Smileydude23/Half-Life---Week-5-Hydroplanter/README.md

# Half-Life---Week-5-Hydroplanter
A plant waterer that uses moisture sensors to detect when the plant needs watering, then a pump will pump water from a bowl/bottle of water to the plant. The design was made in KiCad and the code was made in Arduino IDE. I made this project because my plant, Dusty, is in need of consistent watering and it suffers a lot from when I leave the house for extended periods of time, like when I am camping. The PCB is built around an ESP32-C3 microcontroller. It monitors soil moisture and water level, controls a pump through a MOSFET, manages battery charging and protection, and displays status information on an OLED. The wiring is really trash because I'm bad at wiring but it should work. The Arduino firmware I wrote monitors soil moisture and water-tank availability, displays the plant’s moisture level on an OLED screen, and automatically controls a pump. It starts watering when the soil moisture falls to 30% or below, stops at 55%, and includes safety limits for an empty tank, a 15-second maximum runtime, and a 10-minute delay between watering cycles. It also averages multiple soil-sensor readings, converts them into a 0–100% moisture value, and shows the plant graphic, status, and sensor data on the display.

Onshape Link:
https://cad.onshape.com/documents/5bbc0352c67ef33b2cdba1d2/w/0c9466e1c6beb604306bf71a/e/59fa4b2cb4097b58a1eba9d7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

## Bill of Materials

| Part | Qty | Unit Price (USD) | Total (USD) | Vendor |
| :--- | :---: | :---: | :---: | :--- |
| **1/4" Vinyl Tubing** <br> | 1 | $3.83 | $3.83 | Temu |
| **0.96-inch OLED Display Module I2C** <br> | 1 | $1.98 | $1.98 | Temu |
| **2pcs/lot 18650 Battery Case** <br> | 1 | $1.44 | $1.44 | Temu |
| **MF-RHT050-0** <br> | 2 | $1.87 | $3.74 | Digikey |
| **SS14** <br> | 3 | $1.38 | $4.14 | Digikey |
| **USB4125-GF-A** <br> | 1 | $0.64 | $0.64 | Digikey |
| **IRLZ44NPBF** <br> | 1 | $2.02 | $2.02 | Digikey |
| **FS8205A** <br> | 1 | $0.69 | $0.69 | Digikey |
| **MFR-25FTF52-1K5** <br> | 2 | $0.21 | $0.42 | Digikey |
| **MFR-25FBF52-732K** <br> | 1 | $0.11 | $0.11 | Digikey |
| **DW01A** <br> | 1 | $0.11 | $0.11 | Digikey |
| **BQ24074RGTR** <br> | 1 | $2.73 | $2.73 | Digikey |
| **SMD IC MT3608** <br> | 1 | $0.29 | $0.29 | Digikey |
| **K104K15X7RF53L2** <br> | 2 | $0.57 | $1.14 | Digikey |
| **FK22X7R1E475K0000** <br> | 1 | $1.63 | $1.63 | Digikey |
| **S3B-PH-K-S** <br> | 1 | $0.16 | $0.16 | Digikey |
| **S2B-PH-K-S** <br> | 2 | $0.26 | $0.52 | Digikey |
| **78F4R7J-RC** <br> | 1 | $0.25 | $0.25 | Digikey |
| **I13991054** <br> | 1 | $1.21 | $1.21 | Aliexpress |
| **SEN0193** <br> | 1 | $6.21 | $6.21 | Digikey |
| **4547** <br> | 1 | $3.31 | $3.31 | Digikey |
| **PLS-03IA-3PAI** <br> | 1 | $3.19 | $3.19 | Digikey |
| **50YXJ22MTA5X11** <br> | 1 | $0.28 | $0.28 | Digikey |
| **PCB Manufacturing** <br> | 1 | $4.00 | $4.00 | JLCPCB |
| **Tax & shipping** <br> | — | — | $17.08 | — |
| **Total Funding Used** | — | — | **$61.12 / $65** | |






DigiKey - Shopping Cart
Aliexpress
Temu
JLCPCB
