Smileydude23/Half-Life---Week-5-Hydroplanter/Hydroplanter.xlsx

Reference | Qty | Value | DNP | Exclude from BOM | Exclude from Board | Exclude from Simulation | Exclude from Position Files | Footprint | Datasheet | Personal Notes for Making Half Life BOM |  |  |  |  |  | Store | Price | Site
BT1,BT2 | 2 | BK-18650-PC2 |  |  |  |  | ${EXCLUDE_FROM_POS_FILES} | hydroplanter:BAT_BK-18650-PC2 | https://s3.amazonaws.com/snapeda/datasheet/BK-18650-PC2_MPD.pdf | BK-18650 Single Battery Shield |  |  | Buy 2 |  |  | Temu | 2.03 | https://www.temu.com/ca/2pcs-lot-18650-power-bank-cases-3-7v-high-quality-diy-battery-box-hard-case-container-with-hard-pin-easy-welding-g-601099632413335.htm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
C1,C2 | 2 | 100nf |  |  |  |  | ${EXCLUDE_FROM_POS_FILES} | Capacitor_THT:C_Disc_D5.0mm_W2.5mm_P5.00mm |  | Disc Capacitor (100nf) |  |  | Buy 2 |  |  | Digikey | 0.8
C3 | 1 | 4.7uf |  |  |  |  | ${EXCLUDE_FROM_POS_FILES} | Capacitor_THT:C_Disc_D5.0mm_W2.5mm_P5.00mm |  | Disc Capacitor (4.7uf) |  |  |  |  |  | Digikey | 2.3
C4,C5 | 2 | 22uf |  |  |  |  | ${EXCLUDE_FROM_POS_FILES} | Capacitor_THT:C_Disc_D5.0mm_W2.5mm_P5.00mm |  | Disc Capacitor (22uf) |  |  |  |  |  | Digikey | 0.4
D1,D2,D3 | 3 | SS14 |  |  |  |  | ${EXCLUDE_FROM_POS_FILES} | Diode_SMD:D_SMA | https://www.vishay.com/docs/88746/ss12.pdf | Schottky Diode SS14 |  |  | Buy 3 |  |  | Digikey | 1.95
F1,F2 | 2 | Polyfuse |  |  |  |  | ${EXCLUDE_FROM_POS_FILES} | Fuse:Fuse_Bourns_MF-RHT050 |  | THT Polyfuse |  |  | Buy 2 |  |  | Digikey | 2.64
J1 | 1 | Conn_01x03 (Soil) |  |  |  |  | ${EXCLUDE_FROM_POS_FILES} | Connector_Phoenix_GMSTB:PhoenixContact_GMSTBA_2,5_3-G-7,62_1x03_P7.62mm_Horizontal |  | 3 pin male connector |  |  | Right angle preffered, vertical is fine |  |  | Digikey | 0.22
J2 | 1 | Conn_01x02 (Water) |  |  |  |  | ${EXCLUDE_FROM_POS_FILES} | Connector_Phoenix_GMSTB:PhoenixContact_GMSTBA_2,5_2-G_1x02_P7.50mm_Horizontal |  | 2 pin male connector |  |  | Right angle preffered, vertical is fine |  |  | Digikey | 0.36
J3 | 1 | Conn_01x02 (Pump) |  |  |  |  | ${EXCLUDE_FROM_POS_FILES} | Connector_Phoenix_GMSTB:PhoenixContact_GMSTBA_2,5_2-G_1x02_P7.50mm_Horizontal |  | 2 pin male connector |  |  | Right angle preffered, vertical is fine
J4 | 1 | USB_C_Receptacle_PowerOnly_6P |  |  |  |  | ${EXCLUDE_FROM_POS_FILES} | Connector_USB:USB_C_Receptacle_GCT_USB4125-xx-x-0190_6P_TopMnt_Horizontal | https://www.usb.org/sites/default/files/documents/usb_type-c.zip | 6 pin horizontal USBC power only connector |  |  | Right angle |  |  | Digikey | 0.91
L1 | 1 | 4.7uh |  |  |  |  | ${EXCLUDE_FROM_POS_FILES} | Inductor_THT:L_Axial_L7.0mm_D3.3mm_P10.16mm_Horizontal_Fastron_MICC |  | 4.7uh inductor THT |  |  |  |  | ? | Digikey | 0.85
Q1 | 1 | IRLZ44N |  |  |  |  | ${EXCLUDE_FROM_POS_FILES} | Package_TO_SOT_THT:TO-220-3_Vertical | http://www.irf.com/product-info/datasheets/data/irlz44n.pdf | IRLZ44N |  |  |  |  |  | Digikey | 2.85
Q3 | 1 | FS8205A_C908265 |  |  |  |  | ${EXCLUDE_FROM_POS_FILES} | hydroplanter:SOT-23-6_L2.9-W1.6-P0.95-LS2.8-BR | https://lcsc.com/product-detail/MOSFET_FUXINSEMI-FS8205A_C908265.html | FS8205A |  |  |  |  |  | Digikey | 0.95
R1 | 1 | 330 |  |  |  |  | ${EXCLUDE_FROM_POS_FILES} | Resistor_THT:R_Axial_DIN0207_L6.3mm_D2.5mm_P7.62mm_Horizontal |  | THT Resistor 330ohms |  |  |  | Probably just buy a variety resistor kit at this point
R2,R9 | 2 | 10k |  |  |  |  | ${EXCLUDE_FROM_POS_FILES} | Resistor_THT:R_Axial_DIN0207_L6.3mm_D2.5mm_P7.62mm_Horizontal |  | THT Resistor 10k ohms |  |  | Buy 2
R3,R4 | 2 | 5.1k |  |  |  |  | ${EXCLUDE_FROM_POS_FILES} | Resistor_THT:R_Axial_DIN0207_L6.3mm_D2.5mm_P7.62mm_Horizontal |  | THT Resistor 5.1k ohms |  |  | Buy 2
R5,R6 | 2 | 100 |  |  |  |  | ${EXCLUDE_FROM_POS_FILES} | Resistor_THT:R_Axial_DIN0207_L6.3mm_D2.5mm_P7.62mm_Horizontal |  | THT Resistor 100 ohms |  |  | Buy 2
R7 | 1 | 732k |  |  |  |  | ${EXCLUDE_FROM_POS_FILES} | Resistor_THT:R_Axial_DIN0207_L6.3mm_D2.5mm_P7.62mm_Horizontal |  | THT Resistor 732k ohms |  | x |  |  |  | Digikey | 0.15
R8 | 1 | 100k |  |  |  |  | ${EXCLUDE_FROM_POS_FILES} | Resistor_THT:R_Axial_DIN0207_L6.3mm_D2.5mm_P7.62mm_Horizontal |  | THT Resistor 100k ohms
R10,R11 | 2 | 4.7k |  |  |  |  | ${EXCLUDE_FROM_POS_FILES} | Resistor_THT:R_Axial_DIN0207_L6.3mm_D2.5mm_P7.62mm_Horizontal |  | THT Resistor 4.7k ohms |  |  | Buy 2
R12,R13 | 2 | 1.5k |  |  |  |  | ${EXCLUDE_FROM_POS_FILES} | Resistor_THT:R_Axial_DIN0207_L6.3mm_D2.5mm_P7.62mm_Horizontal |  | THT Resistor 1.5k ohms |  | x | Buy 2 |  |  | Digikey | 0.3
U1 | 1 | XIAO-ESP32-C3-SMD |  |  |  |  | ${EXCLUDE_FROM_POS_FILES} | Imported Parts:XIAO-ESP32-C3-SMD |  | XIAO-ESP32-C3 |  |  |  |  |  | Digikey | 8.31 |  | or Aliexpress
U2 | 1 | DW01A_C351410 |  |  |  |  | ${EXCLUDE_FROM_POS_FILES} | hydroplanter:SOT-23-6_L2.9-W1.6-P0.95-LS2.8-BL | https://lcsc.com/product-detail/Others_PUOLOP-DW01_C351410.html | DW01A |  |  |  |  |  | Digikey | 0.16
U3 | 1 | BQ24074RGT |  |  |  |  | ${EXCLUDE_FROM_POS_FILES} | Package_DFN_QFN:VQFN-16-1EP_3x3mm_P0.5mm_EP1.6x1.6mm | http://www.ti.com/lit/ds/symlink/bq24074.pdf | BQ24074RGT |  |  |  |  |  | Digikey | 3.85
U4 | 1 | DM-OLED096-636 |  |  |  |  | ${EXCLUDE_FROM_POS_FILES} | hydroplanter3d:MODULE_DM-OLED096-636 | https://snapeda.s3.amazonaws.com/datasheets1361-DM-OLED096-636_Datasheet.pdf | DM-OLED096-636 |  |  |  |  |  | Temu | 2.79 | https://www.temu.com/ca/0-96-inch-oled-display-module--128x64--yellow-white-g-601099658217397.html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
U5 | 1 | MT3608 |  |  |  |  | ${EXCLUDE_FROM_POS_FILES} | Package_TO_SOT_SMD:SOT-23-6 | https://www.olimex.com/Products/Breadboarding/BB-PWR-3608/resources/MT3608.pdf | MT3608 |  |  |  |  |  | Digikey | 0.41
 |  |  |  |  |  |  |  |  |  | Shipping |  |  |  |  |  | Digikey | 15
 |  |  |  |  |  |  |  |  |  | Don't forget to add prices for pcb manufacturing
 |  |  |  |  |  |  |  |  |  | as well as taxes, shipping, and conversion to USD
 |  |  |  |  |  |  |  |  |  | Additional Pieces
 |  |  |  |  |  |  |  |  |  | 1/4 inch vinyl tubing (at least 3 ft long) |  |  |  |  |  | Temu | 5.41
 |  |  |  |  |  |  |  |  |  | waterproof wires
 |  |  |  |  |  |  |  |  |  | connectors/wires for the pump, soil, and water sensors. (when I searched it up online, only the soil moisture sensor came with an attachment, (prefferable waterproof)
 |  |  |  |  |  |  |  |  |  | (when I searched it up online, only the soil moisture sensor came with an attachment, (prefferable waterproof)
 |  |  |  |  |  |  |  |  |  |  | (They should have holes, not have pins)
 |  |  |  |  |  |  |  |  |  |  | DC 3-6V pump |  |  |  |  | Digikey | 4.67
 |  |  |  |  |  |  |  |  |  |  | Soil moisture sensor |  |  |  |  | Digikey | 8.76
 |  |  |  |  |  |  |  |  |  |  | float switch (can be normally open or closed doesn't matter) |  |  |  |  | Digikey | 4.5
