Smileydude23/Half-Life---Week-5-Hydroplanter/BOM.csv

Item | Qty | Supplier | Cost/item | Total Cost | link
Small Engine Fuel Line Hose Available in Four Sizes, Each Measuring 5 Feet And 3 Feet, with Inner And Outer Diameters of | 1 | Temu | $3.83 | $3.83 | https://www.temu.com/goods.html?goods_id=601099522497727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
0.96-inch OLED Display Module I2C IIC 128x64 Blue/Blue Yellow/White | 1 | Temu | $1.98 | $1.98 | https://www.temu.com/goods.html?goods_id=601099658217397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
2pcs/lot 18650 Power Bank Cases 3.7V High Quality DIY Battery Box Hard Case Container with Hard Pin Easy Welding | 1 | Temu | $1.44 | $1.44 | https://www.temu.com/goods.html?goods_id=601099632413335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
MF-RHT050-0 | 2 | Digikey | $1.87 | $3.74 | https://www.digikey.ca/en/products/detail/bourns-inc/MF-RHT050-0/6229412
SS14 | 3 | Digikey | $1.38 | $4.14 | https://www.digikey.ca/en/products/detail/onsemi/SS14/965474
USB4125-GF-A | 1 | Digikey | $0.64 | $0.64 | https://www.digikey.ca/en/products/detail/gct/USB4125-GF-A/13547388
IRLZ44NPBF | 1 | Digikey | $2.02 | $2.02 | https://www.digikey.ca/en/products/detail/infineon-technologies/IRLZ44NPBF/811808
FS8205A | 1 | Digikey | $0.69 | $0.69 | https://www.digikey.ca/en/products/detail/evvo/FS8205A/26220994
MFR-25FTF52-1K5 | 2 | Digikey | $0.21 | $0.42 | https://www.digikey.ca/en/products/detail/yageo/MFR-25FTF52-1K5/9140622
MFR-25FBF52-732K | 1 | Digikey | $0.11 | $0.11 | https://www.digikey.ca/en/products/detail/yageo/MFR-25FBF52-732K/13688
DW01A | 1 | Digikey | $0.11 | $0.11 | https://www.digikey.ca/en/products/detail/shenzhen-slkormicro-semicon-co-ltd/DW01A/28143000
BQ24074RGTR | 1 | Digikey | $2.73 | $2.73 | https://www.digikey.ca/en/products/detail/texas-instruments/BQ24074RGTR/2047269
SMD IC MT3608 | 1 | Digikey | $0.29 | $0.29 | https://www.digikey.ca/en/products/detail/olimex-ltd/SMD-IC-MT3608/29208971
K104K15X7RF53L2 | 2 | Digikey | $0.57 | $1.14 | https://www.digikey.ca/en/products/detail/vishay-beyschlag-draloric-bc-components/K104K15X7RF53L2/2820506
FK22X7R1E475KN000 | 1 | Digikey | $1.63 | $1.63 | https://www.digikey.ca/en/products/detail/tdk/FK22X7R1E475KN000/1008923
S3B-PH-K-S | 1 | Digikey | $0.16 | $0.16 | https://www.digikey.ca/en/products/detail/jst-sales-america-inc/S3B-PH-K-S/926627
S2B-PH-K-S | 2 | Digikey | $0.26 | $0.52 | https://www.digikey.ca/en/products/detail/jst-sales-america-inc/S2B-PH-K-S/926626
78F4R7J-RC | 1 | Digikey | $0.25 | $0.25 | https://www.digikey.ca/en/products/detail/bourns-inc/78F4R7J-RC/1306001
113991054 | 1 | Aliexpress | $1.21 | $1.21 | https://www.aliexpress.com/item/1005008791937363.html?mp=1
SEN0193 | 1 | Digikey | $6.21 | $6.21 | https://www.digikey.ca/en/products/detail/dfrobot/SEN0193/6588605
4547 | 1 | Digikey | $3.31 | $3.31 | https://www.digikey.ca/en/products/detail/adafruit-industries-llc/4547/11627730
PLS-031A-3PAI | 1 | Digikey | $3.19 | $3.19 | https://www.digikey.ca/en/products/detail/pic-gmbh/PLS-031A-3PAI/9687292
50YXJ22MTA5X11 | 1 | Digikey | $0.28 | $0.28 | https://www.digikey.ca/en/products/detail/rubycon/50YXJ22MTA5X11/3134939
PCB Manufacturing | 1 | JLCPCB | $4.00 | $4.00 | https://trade.jlcpcb.com/checkout/payMethod/?unionSettleId=cabd77b163cd4992b6d58ca73438223e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
Estimated total shipping | 1 |  |  | $17.08
