Smileydude23/Half-Life---Week-5-Hydroplanter/Hydroplanter.step

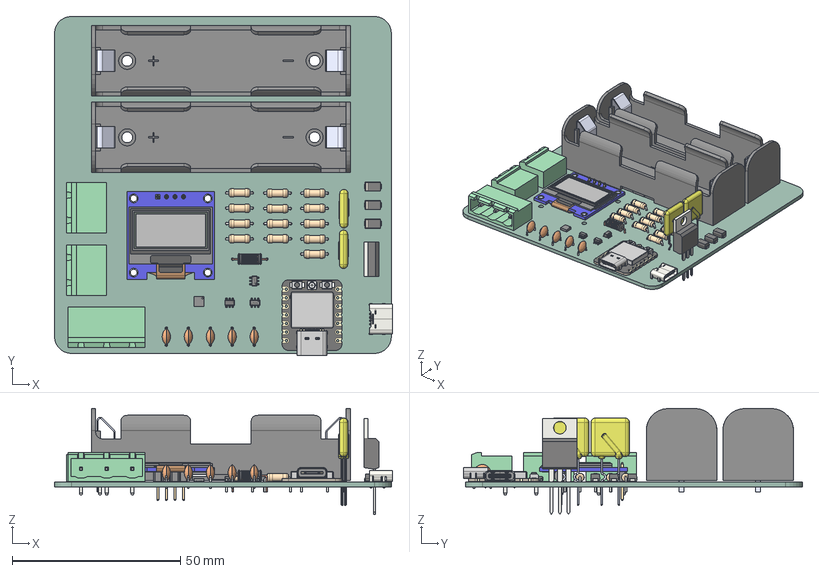
[picture p1: CAD file, 2026-11-08]
Hydroplanter.step
100.3 x 100.6 x 31.5 mm
R_Axial_DIN0207_L63mm_D25mm_P762mm_Horizontal x 13
C_Disc_D50mm_W25mm_P500mm x 5
DM-OLED096-636_Module
DM-OLED096-636_Panel
RGT16
SOT-23-6_L2.9-W1.6-H1.5-LS2.8-P0.95 x 2
GMSTBA_01x03_G_7_62mm
BK-18650-PC2 x 2
D_SMA x 3
GMSTBA_01x02_G_7_50mm x 2
USB_C_Receptacle_GCT_USB4125-xx-x_6P_TopMnt_Horizontal
SOT-23-6
L_Axial_L7.0mm_D3.3mm_P10.16mm_Horizontal_Fastron_MICC
TO-220-3_Vertical
30R250UU x 2
BOSS-EXTRUDE14_8_
BOSS-EXTRUDE7_4_
BOSS-EXTRUDE7_3_
BOSS-EXTRUDE14_4_
BOSS-EXTRUDE14_2_
BOSS-EXTRUDE14_11_
BOSS-EXTRUDE7_7_
BOSS-EXTRUDE14_9_
BOSS-EXTRUDE14_3_
BOSS-EXTRUDE14_7_
MIRROR2
BOSS-EXTRUDE14_5_
BOSS-EXTRUDE14_12_
BOSS-EXTRUDE7_8_
BOSS-EXTRUDE7_1_
BOSS-EXTRUDE14_10_
BOSS-EXTRUDE7_9_
BOSS-EXTRUDE14_6_
BOSS-EXTRUDE14_1_
BOSS-EXTRUDE7_6_
BOSS-EXTRUDE7_2_
CUT-EXTRUDE5
BOSS-EXTRUDE7_5_
U.FL Connector v1
Button (1) x 2
Shield
HydF854_PCB
