Smileydude23/Half-Life---Week-5-Hydroplanter/Hydroplanter.kicad_pcb

## KiCad design Hydroplanter.kicad_pcb (2026-11-08)

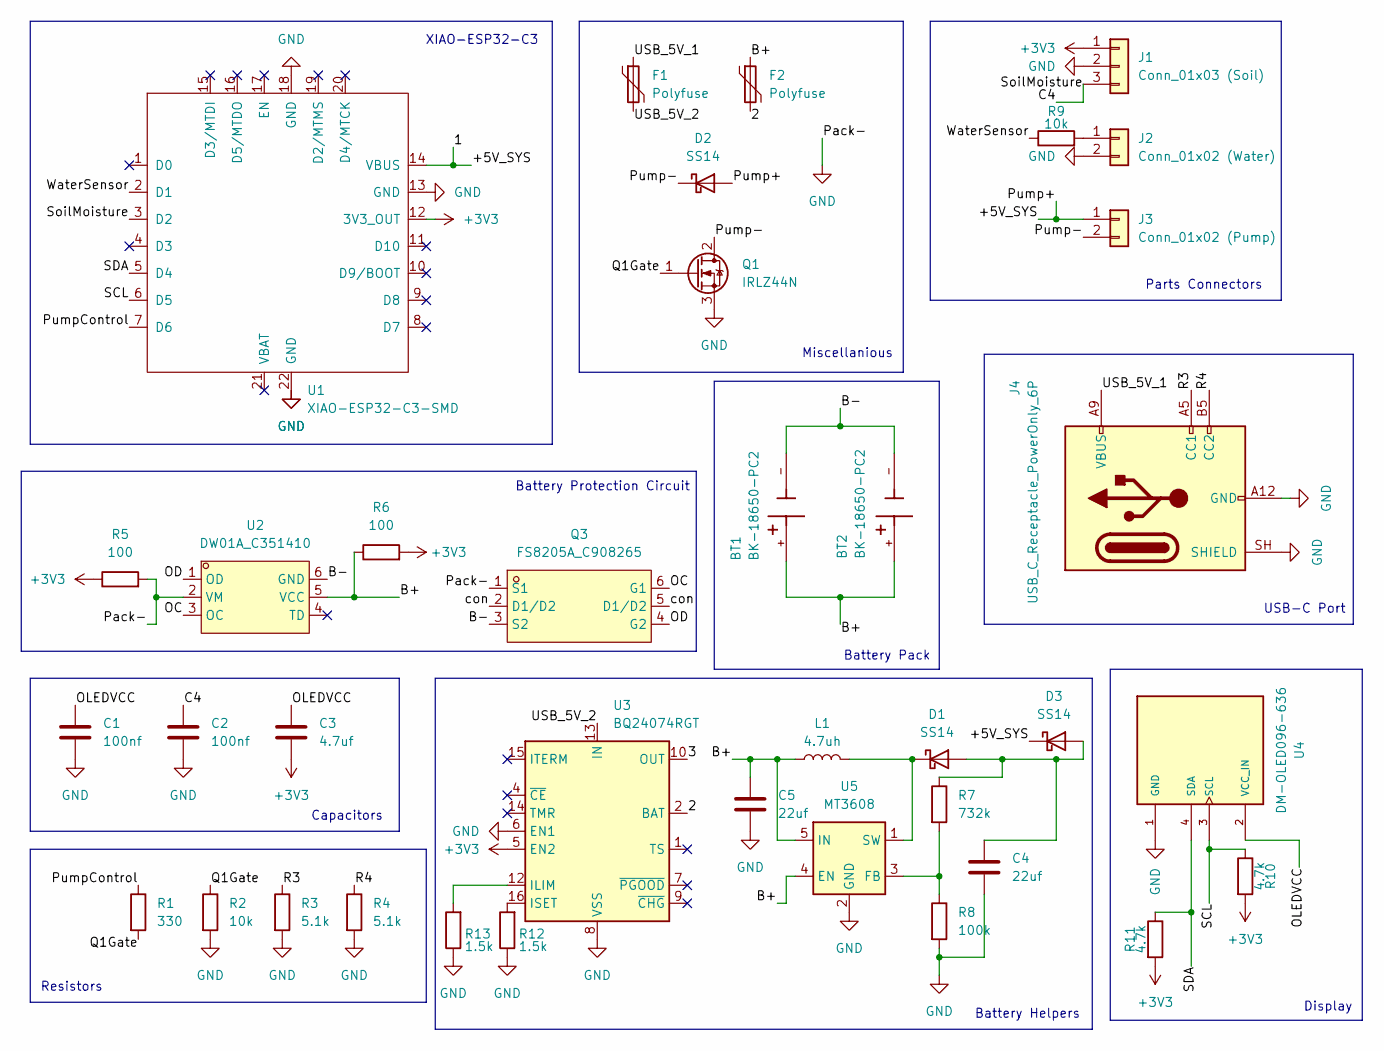
[picture p2: schematic Hydroplanter.kicad_sch]

Parts:
BT1, BT2: BK-18650-PC2; BAT_BK-18650-PC2; MPN BK-18650-PC2
C1, C2: 100nf; C_Disc_D5.0mm_W2.5mm_P5.00mm
C3: 4.7uf; C_Disc_D5.0mm_W2.5mm_P5.00mm
C4, C5: 22uf; C_Disc_D5.0mm_W2.5mm_P5.00mm
D1, D2, D3: SS14; D_SMA
F1, F2: Polyfuse; Fuse_Bourns_MF-RHT050
J1: Conn_01x03 (Soil); PhoenixContact_GMSTBA_2,5_3-G-7,62_1x03_P7.62mm_Horizontal
J2: Conn_01x02 (Water); PhoenixContact_GMSTBA_2,5_2-G_1x02_P7.50mm_Horizontal
J3: Conn_01x02 (Pump); PhoenixContact_GMSTBA_2,5_2-G_1x02_P7.50mm_Horizontal
J4: USB_C_Receptacle_PowerOnly_6P; USB_C_Receptacle_GCT_USB4125-xx-x-0190_6P_TopMnt_Horizontal
L1: 4.7uh; L_Axial_L7.0mm_D3.3mm_P10.16mm_Horizontal_Fastron_MICC
Q1: IRLZ44N; TO-220-3_Vertical
Q3: FS8205A_C908265; SOT-23-6_L2.9-W1.6-P0.95-LS2.8-BR; MPN FS8205A; LCSC Part C908265
R1: 330; R_Axial_DIN0207_L6.3mm_D2.5mm_P7.62mm_Horizontal
R2, R9: 10k; R_Axial_DIN0207_L6.3mm_D2.5mm_P7.62mm_Horizontal
R3, R4: 5.1k; R_Axial_DIN0207_L6.3mm_D2.5mm_P7.62mm_Horizontal
R5, R6: 100; R_Axial_DIN0207_L6.3mm_D2.5mm_P7.62mm_Horizontal
R7: 732k; R_Axial_DIN0207_L6.3mm_D2.5mm_P7.62mm_Horizontal
R8: 100k; R_Axial_DIN0207_L6.3mm_D2.5mm_P7.62mm_Horizontal
R10, R11: 4.7k; R_Axial_DIN0207_L6.3mm_D2.5mm_P7.62mm_Horizontal
R12, R13: 1.5k; R_Axial_DIN0207_L6.3mm_D2.5mm_P7.62mm_Horizontal
U1: XIAO-ESP32-C3-SMD
U2: DW01A_C351410; SOT-23-6_L2.9-W1.6-P0.95-LS2.8-BL; MPN DW01A; LCSC Part C351410
U3: BQ24074RGT; VQFN-16-1EP_3x3mm_P0.5mm_EP1.6x1.6mm
U4: DM-OLED096-636; MODULE_DM-OLED096-636; MPN DM-OLED096-636
U5: MT3608; SOT-23-6

Connections:
+3V3: C3.2, J1.1, R5.1, R6.2, R10.2, R11.2, U1.12 (3V3_OUT), U3.5 (EN2)
/2: F2.2, U3.2 (BAT), U3.3 (BAT)
/3: U3.10 (OUT), U3.11 (OUT)
/+5V_SYS: D2.2 (A), D3.1 (K), J3.1, U1.14 (VBUS)
/B+: BT1.+, BT2.+, C5.1, F2.1, L1.1, R6.1, U2.5 (VCC), U5.4 (EN), U5.5 (IN)
/B-: BT1.-, BT2.-, Q3.3 (S2), U2.6 (GND)
/C4: C2.1, J1.3, U1.3 (D2)
/OC: Q3.6 (G1), U2.3 (OC)
/OD: Q3.4 (G2), U2.1 (OD)
/OLEDVCC: C1.1, C3.1, U4.2 (VCC_IN)
/Pump-: D2.1 (K), J3.2, Q1.2 (D)
/PumpControl: R1.1, U1.7 (D6)
/Q1Gate: Q1.1 (G), R1.2, R2.1
/R3: J4.A5 (CC1), R3.1
/R4: J4.B5 (CC2), R4.1
/SCL: R10.1, U1.6 (D5), U4.3 (SCL)
/SDA: R11.1, U1.5 (D4), U4.4 (SDA)
/USB_5V_1: F1.1, J4.A9 (VBUS), J4.B9 (VBUS)
/USB_5V_2: F1.2, U3.13 (IN)
/WaterSensor: R9.1, U1.2 (D1)
/con: Q3.2 (D1/D2), Q3.5 (D1/D2)
GND: C1.2, C2.2, C4.2, C5.2, J1.2, J2.2, J4.A12 (GND), J4.B12 (GND), J4.SH (SHIELD), Q1.3 (S), Q3.1 (S1), R2.2, R3.2, R4.2, R5.2, R8.2, R12.1, R13.1, U1.13 (GND), U1.18 (GND), U1.22 (GND), U2.2 (VM), U3.6 (EN1), U3.8 (VSS), U3.17 (VSS), U4.1 (GND), U5.2 (GND)
unnamed: C4.1, D1.2 (A), D3.2 (A), R7.1
unnamed: D1.1 (K), L1.2, U5.1 (SW)
unnamed: J2.1, R9.2
unnamed: R13.2, U3.12 (ILIM)
unnamed: R12.2, U3.16 (ISET)
unnamed: R7.2, R8.1, U5.3 (FB)

Notes on the sheet:
Battery Pack
USB-C Port
XIAO-ESP32-C3
Resistors
Battery Protection Circuit
Miscellanious
Battery Helpers
Capacitors
Parts Connectors
Display

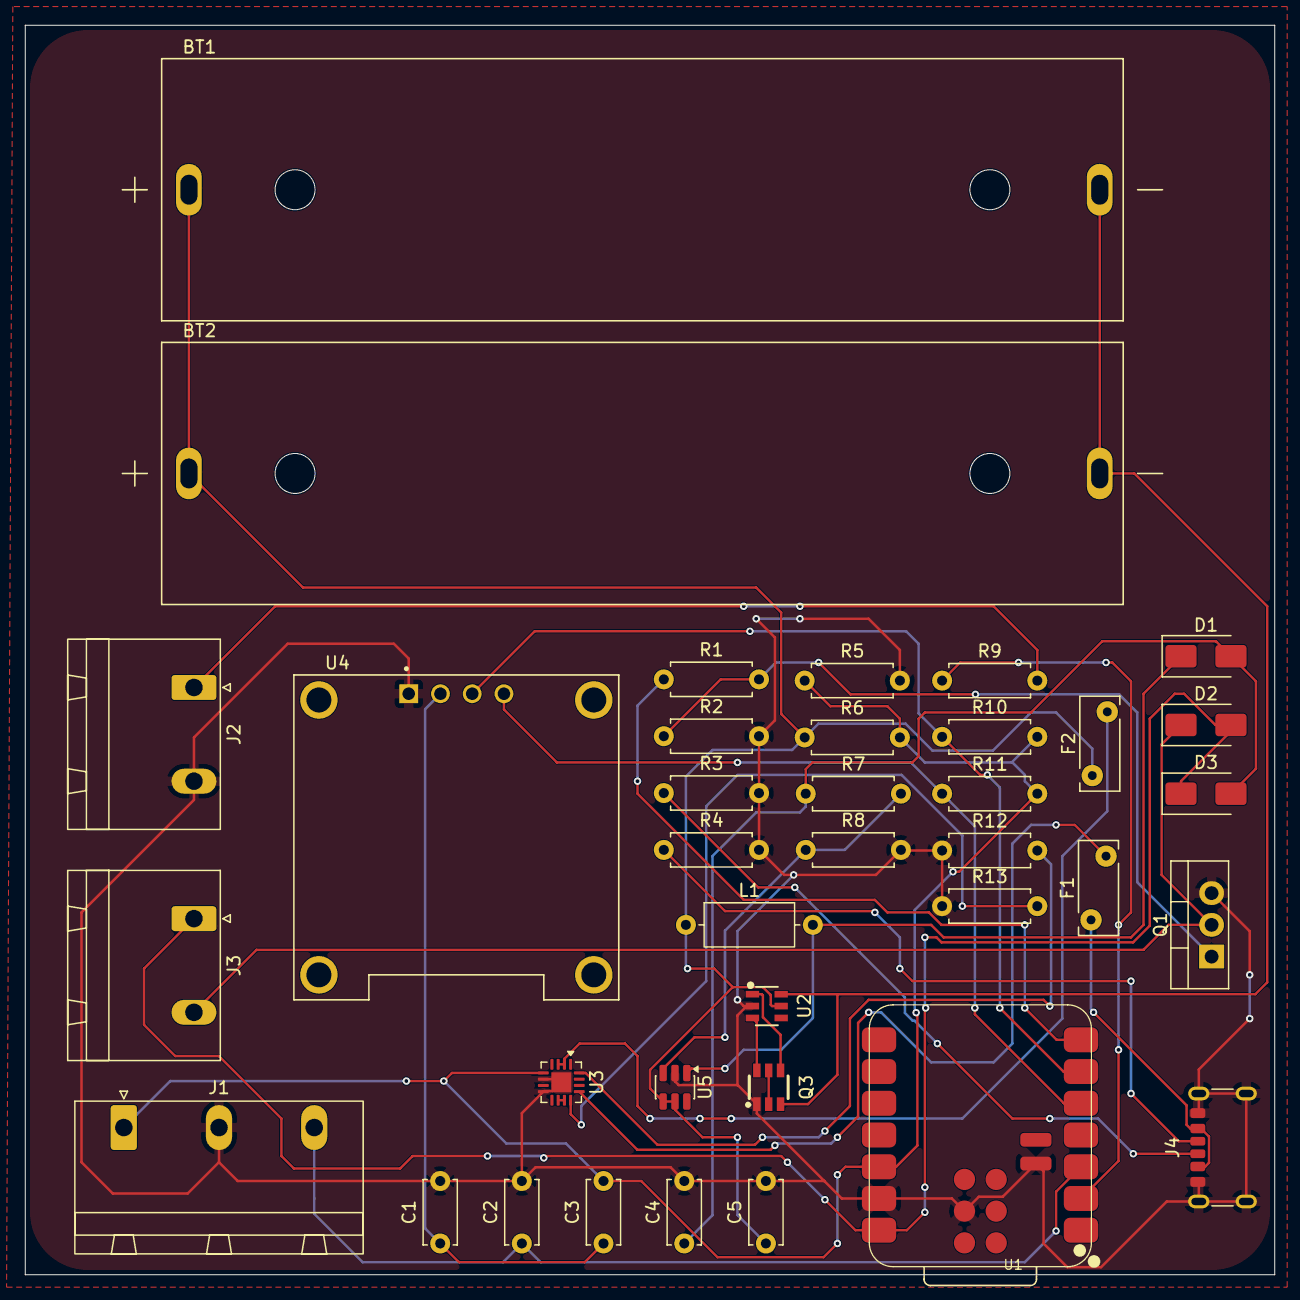
[picture p3: board Hydroplanter.kicad_pcb from above]

Board: 2 copper layers, 100.0 x 100.0 mm, 37 parts (0 on the bottom side), 28 nets.
