Smileydude23/Half-Life---Week-5-Hydroplanter/(commit log)

2026-11-08 Big File Dump
    [Hydroplanter.kicad_pcb, Hydroplanter.kicad_sch, Hydroplanter.step, Hydroplanter.xlsx]
2026-11-09 New Gerber Files
2026-11-09 Sync Hydroplanter from Half Life
    [BOM.csv]
2026-11-09 New Excel Sheet
    [Hydroplanter.xlsx]
